sukh5190/Solar-Powered-WiFi-Weather-Station/BOM_Weather Station.xlsx

BOM of Solar WiFi Weather Station
Components Price
SL No | Part Name | Designator | Footprint | Quantity | Parts Description
1 | BATTERY HOLDER | BAT | 18650 BATTERY HOLDER | 1 | DIP 18650battery holder
2 | 0.1uF | C1,C2,C4,C5 | CERAMIC-5.08 | 4 | Ceramic Capacitors -0.1uF 5.08mm
3 | 100uF / 16V | C3 | CAP-D5.0XF2.0 | 1 | Electrolytic Capacitor - 100uF/16V
4 | TVS Diode Array | D1 | SOT-23-6_L2.9-W1.6-P0.95-LS2.8-BL | 1 | Diode- DT1042-04SO
5 | JUMPER | JP1 | 1X02 | 1 | Jumper 2.54mm
 | 2 pin Male Header | Header for JP1 | Male header 1*2pin 2.54mm | 1 | Male Pin header 1*10pin 2.54mm
6 | 4 pin Female Headers | BME280,P1,P2,P3 | I2C HEADER | 4 | Female header 1*4pin 2.54mm height8.5mm
7 | Slide Switch | PWR | SWITCH-SPDT_MINI_SLIDE | 1 | SS12D00G3
8 | 1k | R1,R2 | R_AXIAL-0.4 | 2 | Metal resistor 1/4W, 1% tolerance - 1K
9 | 10k | R3 | R_AXIAL-0.4 | 1 | Metal resistor 1/4W, 1% tolerance - 10K
10 | 4.7k | R4,R5,R6 | R_AXIAL-0.4 | 3 | Metal resistor 1/4W, 1% tolerance - 4.7K
11 | 27k | R7 | R_AXIAL-0.4 | 1 | Metal resistor 1/4W, 1% tolerance - 27K
12 | 100k | R8 | R_AXIAL-0.4 | 1 | Metal resistor 1/4W, 1% tolerance - 100K
13 | Rain Sensor | RJ1 | RJ11-6PP | 1 | RJ11 Connector -6pins
14 | Wind Sensor | RJ2 | RJ11-6PP | 1 | RJ11 Connector -6pins
15 | BME280 | U1 | BME280 | 1 | GY-BME280-3.3 3.3V
16 | Screw Terminals 3.5mm-3P | U2 | SCREW TERMINALS 3.5MM-3P | 1 | 3 pin Screw Terminal 3.5mm
17 | ESP32 | U3 | ESP32 DEVKIT V1 (DOIT) | 1 | ESP32 Devlopement Board -30pins
18 | 15 pin Female Headers | Header for ESP32 | 1 x 15 , 2.54 mm pitch | 2 | Female header 1*3pin 2.54mm height8.5mm
18 | TC1262-3.3VDBTR （new versioin no use MCP1700-3.3) | TC1262-3.3VDBTR （new versioin no use MCP1700-3.3) | TC1262-3.3VDBTR(new version no use MCP1700-3.3, TO92) | 1 | TC1262-3.3VDBTR(no use LDO MCP1700-3.3V)
19 | TP4056 MODULE | U6 | TP4056 | 1 | TP4056 18650 Micro USB
20 | Screw Terminal | Solar In | KF301-2P | 1 | KF301 2PIN 5.0MM
21 | Spare Female Headers | Spare | 1 x 15 , 2.54 mm pitch | 1 | female header 1*10pin 2.54mm height 8.5mm
 |  |  |  | 33
Other Components
1 | Solar Panel - 1.25W | Solar Panel | 110 x 69mm | 1 | Solar Panel - 5V / 250mA , 110 x 69mm
PCB Price
1 | PCB V2.0 | PCB | 1 | 1 | PCB for Weather Station V3.0
