sukh5190/Solar-Powered-WiFi-Weather-Station/Schematic_Weather+Station.pdf

Power Supply | Bat. Volt Monitoring

## ESP32

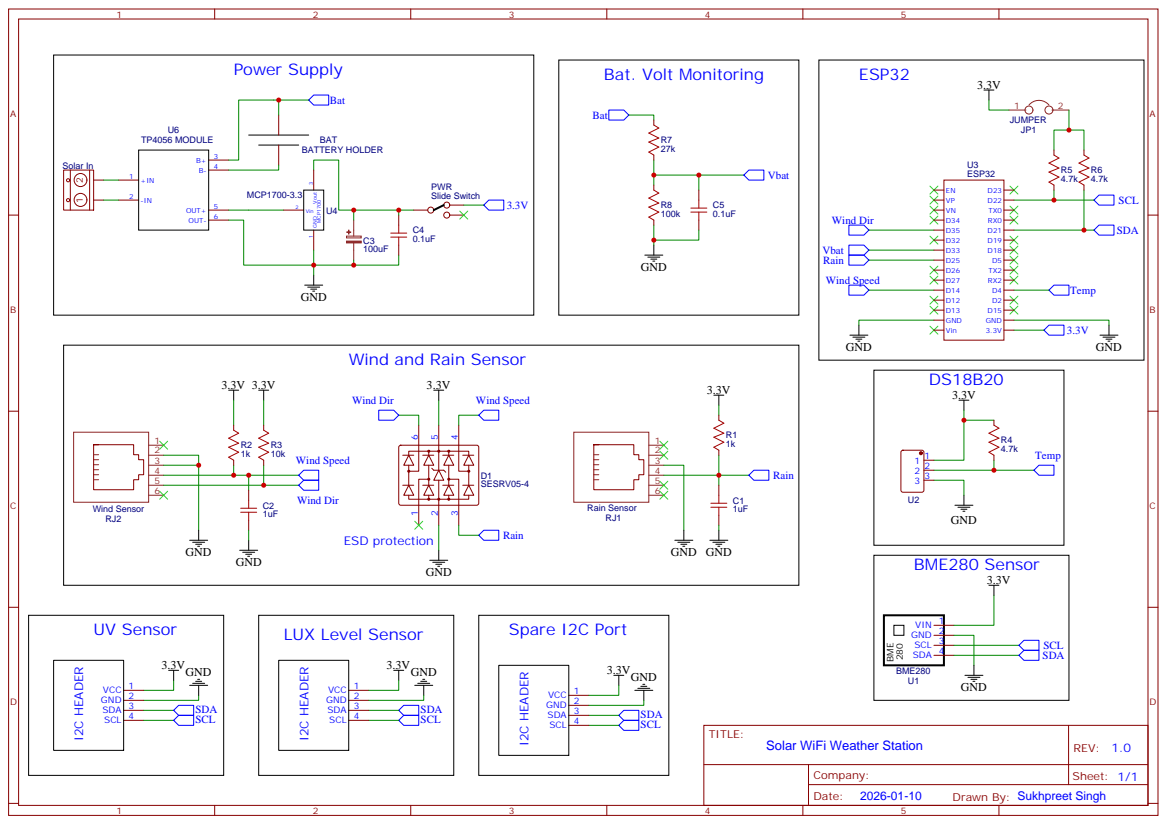
[picture p1: page 1]

Wind and Rain Sensor

Solar WiFi Weather Station
